Riven-Huang/Photography_Fill_Light/docs/market_report_60w_80w_fill_lights_2026-03-22.md

# 60W-80W 便携型补光灯竞品对比报告

更新日期：2026-03-22

## 1. 报告目的

我写这份报告的目的很明确：如果后续把 `Photography_Fill_Light` 项目继续推进为便携型补光灯，我需要先看清它与市面主流 60W-80W 产品之间的差距，以及更合适的对标对象和价格区间。

## 2. 项目介绍

### 2.1 项目定位

我当前推进的是一个便携型补光灯方向的电子设计项目。项目的核心不是单独完成一块驱动板，而是围绕 `60W-80W` 功率段，逐步形成一套具备继续商品化潜力的补光灯方案。

从现有资料看，这个项目目前还处在样机与控制验证阶段，因此我对它的定义更偏向：

- 便携型补光灯方向的控制原型
- 以电源、恒流和调光为核心的技术样机
- 尚未完成整机工业设计和商品化指标闭环

### 2.2 目标方向

从当前讨论方向看，我把这个项目的目标理解为：

- 面向便携型补光灯赛道
- 功率落在 `60W-80W` 区间
- 强调稳定调光和连续光输出
- 后续需要与神牛、优篮子、智云等便携型产品做正面对比

从市场对比角度出发，我后续更关心的不是“能不能点亮”，而是它最终能否落到下面这些整机属性上：

- 是否足够便携
- 是否具备合适的供电方式
- 是否具备可接受的亮度和噪声表现
- 是否能进入合理价格区间

### 2.3 当前技术路线

结合现有文档和代码，我对本项目当前技术路线的概括是：

- 采用 `Boost + 线性恒流` 的总体架构
- 通过 `ADC + DMA` 进行采样与标定
- 通过 `PI` 控制完成母线调节
- 通过 `EC11` 完成交互与调光输入
- 已经具备软启动、过压保护和基本状态机逻辑

这条路线的特点是控制思路比较清晰，便于先把恒流、调光和动态余量控制做好；但如果继续朝便携型成品推进，后续还必须补齐结构、散热、供电、重量和噪声等整机问题。

### 2.4 当前完成情况

目前已经完成的部分主要包括：

- `ADC + DMA` 采样与标定
- `Boost + 线性恒流` 控制框架
- `PI` 调压、软启动、过压保护、状态机
- `EC11` 调光交互

目前还缺少、且无法直接与市售产品对比的数据主要包括：

- 1m 照度
- 整机重量
- 满功率风扇噪声
- 供电方式与续航能力
- 实际整机效率

基于这些现状，我目前认为本项目已经具备继续做市场对标分析的基础，但还没有进入“整机定型”的阶段。

## 3. 我关注的对比重点

在这类便携型补光灯上，我认为真正决定竞争力的不是单一功率，而是下面几项：

- 重量
- 供电方式
- 1m 照度
- 显指
- 风扇噪声
- 售价

市面主流 60W-80W 便携型产品，通常已经把这些点做到比较完整：

- 重量大致控制在 `250g-700g`
- 普遍支持 `PD`、`NP-F`、手柄电池或外接电池
- 有比较清晰的 1m 照度宣传口径
- 显指通常标到 `CRI 95+`
- 价格大致集中在 `579-1399 元`

而本项目当前最明显的差距是：

- 便携供电方案还没有定型
- 整机重量目标还没有锁定
- 照度、噪声、效率还没有实测数据
- 当前优势主要仍然停留在控制架构层面

## 4. 重点竞品对比

### 4.1 Godox ML60II Bi

`Godox ML60II Bi` 我把它视为便携专业型的基准产品之一。

公开可见参数大致为：

- 功率：`70W`
- 色温：`2800K-6500K`
- 显指：`CRI 96 / TLCI 97`
- 照度：`22500 lux @1m, 5600K, 带标罩`
- 重量：约 `526g`
- 供电：`AC`、`NP-F`、V 口扩展
- 价格：约 `898 元`

和本项目相比，我看到的差异主要是：

- 它已经完成整机形态
- 它的便携供电方案成熟
- 它的亮度口径清晰
- 它的品牌和附件生态完整

如果我后续把本项目定位为便携专业型，我认为至少要在下面几项尽量接近它：

- 重量
- 供电方式
- 1m 照度
- 风扇噪声

淘宝截图预留：

- 这里插入 `Godox ML60II Bi` 商品主图
- 这里插入 `Godox ML60II Bi` 价格页截图
- 这里插入 `Godox ML60II Bi` 参数页截图

### 4.2 Ulanzi EC65

`Ulanzi EC65` 我把它看成轻量化和平价便携路线的代表产品。

公开可见参数大致为：

- 功率：`65W`
- 色温：`2500K-6500K`
- 显指：`CRI 95+`
- 重量：约 `250g`
- 供电：`PD`、`DC`、部分套餐带电池
- 价格：`579 元` 起

这款产品最强的地方不是绝对亮度，而是：

- 够轻
- 够便宜
- 便携感强

和本项目相比，它给我的提醒是：

- 如果我把价格目标压到 `599-699 元` 区间，就会直接面对这种低价轻量型产品
- 如果本项目在重量和供电上没有优势，仅靠控制架构本身并不足以形成竞争力

淘宝截图预留：

- 这里插入 `Ulanzi EC65` 商品主图
- 这里插入 `Ulanzi EC65` 套餐价格截图
- 这里插入 `Ulanzi EC65` 参数页截图

### 4.3 ZHIYUN MOLUS X60

`ZHIYUN MOLUS X60` 在我看来代表的是极致小体积便携路线。

公开可见参数大致为：

- 功率：`60W`
- 色温：`2700K-6500K`
- 显指：主流公开口径为 `CRI 95+ / TLCI 97+`
- 供电：`PD`、手柄电池、适配器扩展
- 价格：促销时约 `709 元`

这款产品的核心卖点不是单纯参数，而是：

- 小体积
- 适合外拍
- 整机看起来就是便携创作工具

和本项目相比，我更关注的不是光学参数差异，而是产品完成度差异：

- 本项目当前仍然偏控制原型
- `MOLUS X60` 已经是成熟的便携产品逻辑

淘宝截图预留：

- 这里插入 `ZHIYUN MOLUS X60` 商品主图
- 这里插入 `ZHIYUN MOLUS X60` 价格页截图
- 这里插入 `ZHIYUN MOLUS X60` 供电或尺寸截图

### 4.4 SmallRig RC 60B

`SmallRig RC 60B` 我把它归类为便携型里更强调整机完整度的一类产品。

公开可见参数大致为：

- 功率：`63W`
- 色温：`2700K-6500K`
- 显指：`CRI 97 / TLCI 98 / SSI 89`
- 照度：`11200-13000 lux @1m, 带反光罩`
- 电池：内置约 `49Wh`
- 重量：约 `650g`
- 价格：约 `1369 元`

这类产品的竞争逻辑不是低价，而是：

- 整机完成度高
- 电池方案完整
- 规格表达更完整

和本项目相比，它说明了一件事：如果我未来希望把本项目推向中高端便携型，就不能只把灯头做出来，还需要同时把下面几项补齐：

- 续航
- 便携供电
- 整机做工
- 用户体验

淘宝截图预留：

- 这里插入 `SmallRig RC 60B` 商品主图
- 这里插入 `SmallRig RC 60B` 电池或续航截图
- 这里插入 `SmallRig RC 60B` 价格页截图

### 4.5 amaran COB 60x S

`amaran COB 60x S` 我把它看成 60W 档位里偏专业、偏完整规格的强势竞品。

公开可见参数大致为：

- 输出功率：`65W`
- 最大功耗：`78W`
- 色温：`2700K-6500K`
- 显指：`CRI 96+ / TLCI 97+ / SSI(T) 90+ / SSI(D56) 87+`
- 照度：`33300 lux @1m, 带反光罩`
- 供电：`AC`、双 `NP-F`、电池扩展
- 重量：约 `695g`
- 价格：约 `1094 元`

这款产品对我的参考价值主要在于：

- 如果我不把最低价作为主要竞争点
- 而是更重视“更专业、更稳定、更完整”

那么 `amaran COB 60x S` 会比单纯观察低价产品更有参考意义。

淘宝截图预留：

- 这里插入 `amaran COB 60x S` 商品主图
- 这里插入 `amaran COB 60x S` 参数页截图
- 这里插入 `amaran COB 60x S` 价格页截图

## 5. 我的直接结论

如果只看便携型路线，我当前更倾向于把本项目目标先收敛到下面这个范围：

- 功率：`60W-70W`
- 色温：`双色温`
- 供电：优先支持 `PD 100W`
- 重量：尽量进入 `700g` 以内
- 售价：优先落在 `599-899 元`

从竞品情况看，我当前对标优先级的判断是：

第一优先级：

- `Godox ML60II Bi`
- `Ulanzi EC65`

第二优先级：

- `ZHIYUN MOLUS X60`

第三优先级：

- `amaran COB 60x S`
- `SmallRig RC 60B`

我这样排序的原因也很直接：

- `ML60II Bi` 是便携专业型的主流基准
- `EC65` 是低价轻量路线的直接压力
- `X60` 代表小体积便携设计方向
- `amaran` 和 `SmallRig` 更适合做高位规格参考

## 6. BOM 成本测算预留

### 6.1 核心电子 BOM

| 模块 | 器件/规格 | 型号/方案 | 单价(元) | 数量  | 小计(元) | 备注  |
| --- | --- | --- | ----- | --- | ----- | --- |
| 主控 | MCU | STM32F030F4P6TR  | | 1 | | |
| Boost 驱动 | 半桥驱动 | MP1907 | | 1 | | |
| 运放 | 恒流控制运放 | TLV2372 | | 1 | | |
| 主功率 MOS  | Boost 功率管 | | | 2 | | |
| 线性 MOS | 恒流调整管 | IXTH30N50L2 | | 1 | | |
| 电感 | 主电感 | 33uH | | 1 | | |
| 采样电阻 | 恒流采样 | 0.1 ohm | | 1 | | |
| 降压电源 | 电源级 | MP4420 / MP20051 | | 3 | | |
| 编码器 | 人机交互 | EC11 | | 1 | | |
| 风扇驱动 | 低边 MOS | AO3400A | | 1 | | |
| COB 光源 | LED 模组 | | | 1 | | |
| 其他被动件 | 电阻/电容/二极管/连接器 | | | 1批  | | |

### 6.2 结构与散热 BOM

| 模块 | 器件/规格 | 型号/方案 | 单价(元) | 数量  | 小计(元) | 备注  |
| ----- | --- | ----- | ----- | --- | ----- | --- |
| 散热器 | 铝型材/压铸件  | | | 1 | | |
| 风扇 | 散热风扇 | | | 1 | | |
| 外壳 | 上下盖/边框 | | | 1套  | | |
| 支架/手柄 | 结构附件 | | | 1 | | |
| 导热材料  | 导热垫/导热硅脂 | | | 1批  | | |
| 紧固件 | 螺丝/铜柱/垫片 | | | 1批  | | |

### 6.3 供电、包装与附件 BOM

| 模块 | 器件/规格 | 型号/方案 | 单价(元) | 数量  | 小计(元) | 备注  |
| --- | --- | ----- | ----- | --- | ----- | --- |
| 适配器 | AC-DC 电源 | | | 1 | | |
| PD 供电板 | 若采用 PD 方案 | | | 1 | | |
| 电池方案 | 若采用电池包/手柄电池 | | | 1 | | |
| 反光罩 | 标配附件 | | | 1 | | |
| 线材 | 电源线/转接线 | | | 1批  | | |
| 包装盒 | 彩盒/内衬 | | | 1 | | |
| 说明书 | 文档印刷 | | | 1 | | |

### 6.4 成本汇总

| 项目 | 金额(元) | 备注  |
| --- | ----- | --- |
| 核心电子 BOM 小计 | | |
| 结构与散热 BOM 小计 | | |
| 供电、包装与附件 BOM 小计 | | |
| 加工与试产损耗 | | |
| 预计整机物料成本 | | |
| 目标出厂价 | | |
| 目标零售价 | | |

## 7. 参考来源

- 项目文档与代码：
  - `docs/CURRENT_OPERATION_MANUAL.md`
  - `docs/DYNAMIC_HEADROOM_STRATEGY.md`
  - `program/app/program.c`
  - `program/app/state_machine.c`
- 竞品公开资料：
  - Godox ML60II Bi 中国首发信息：<https://news.zol.com.cn/877/8779347.html>
  - Godox ML60II Bi 渠道规格页：<https://jonocraztech.cyberbiz.co/products/godox_ml60ii_bi>
  - Ulanzi EC65 首发报道：<https://www.ithome.com/0/836/183.htm>
  - Ulanzi EC65 官方页：<https://www.ulanzieg.com/products/ulanzi-ec65-65w-portable-bi-color-led-video-light>
  - ZHIYUN MOLUS X60 官方商城：<https://store.zhiyun-tech.com/products/molus-x60>
  - SmallRig RC 60B 官方页：<https://www.smallrig.com/RC-60B-COB-LED-Video-Light.html>
  - SmallRig RC 60B 零售页：<https://www.walmart.com/ip/5205392629>
  - amaran COB 60x S 官方页：<https://amarancreators.com/products/amaran-cob-60x-s>
