Riven-Huang/Photography_Fill_Light/docs/images/架构图.png

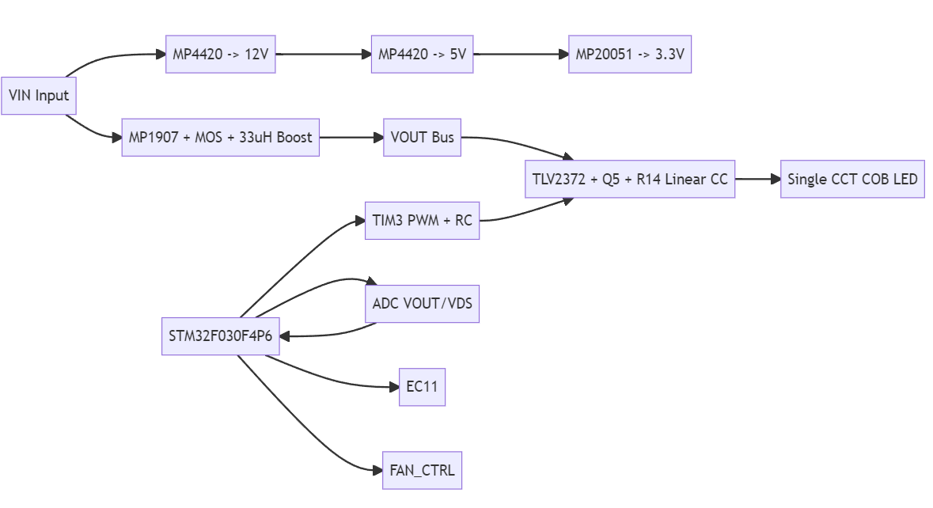
docs/images/架构图.png
