Riven-Huang/Photography_Fill_Light/circurit/SCH_Schematic1_2026-03-04.pdf

STM32F030F4P6TR | POWER | Auxiliary POWER

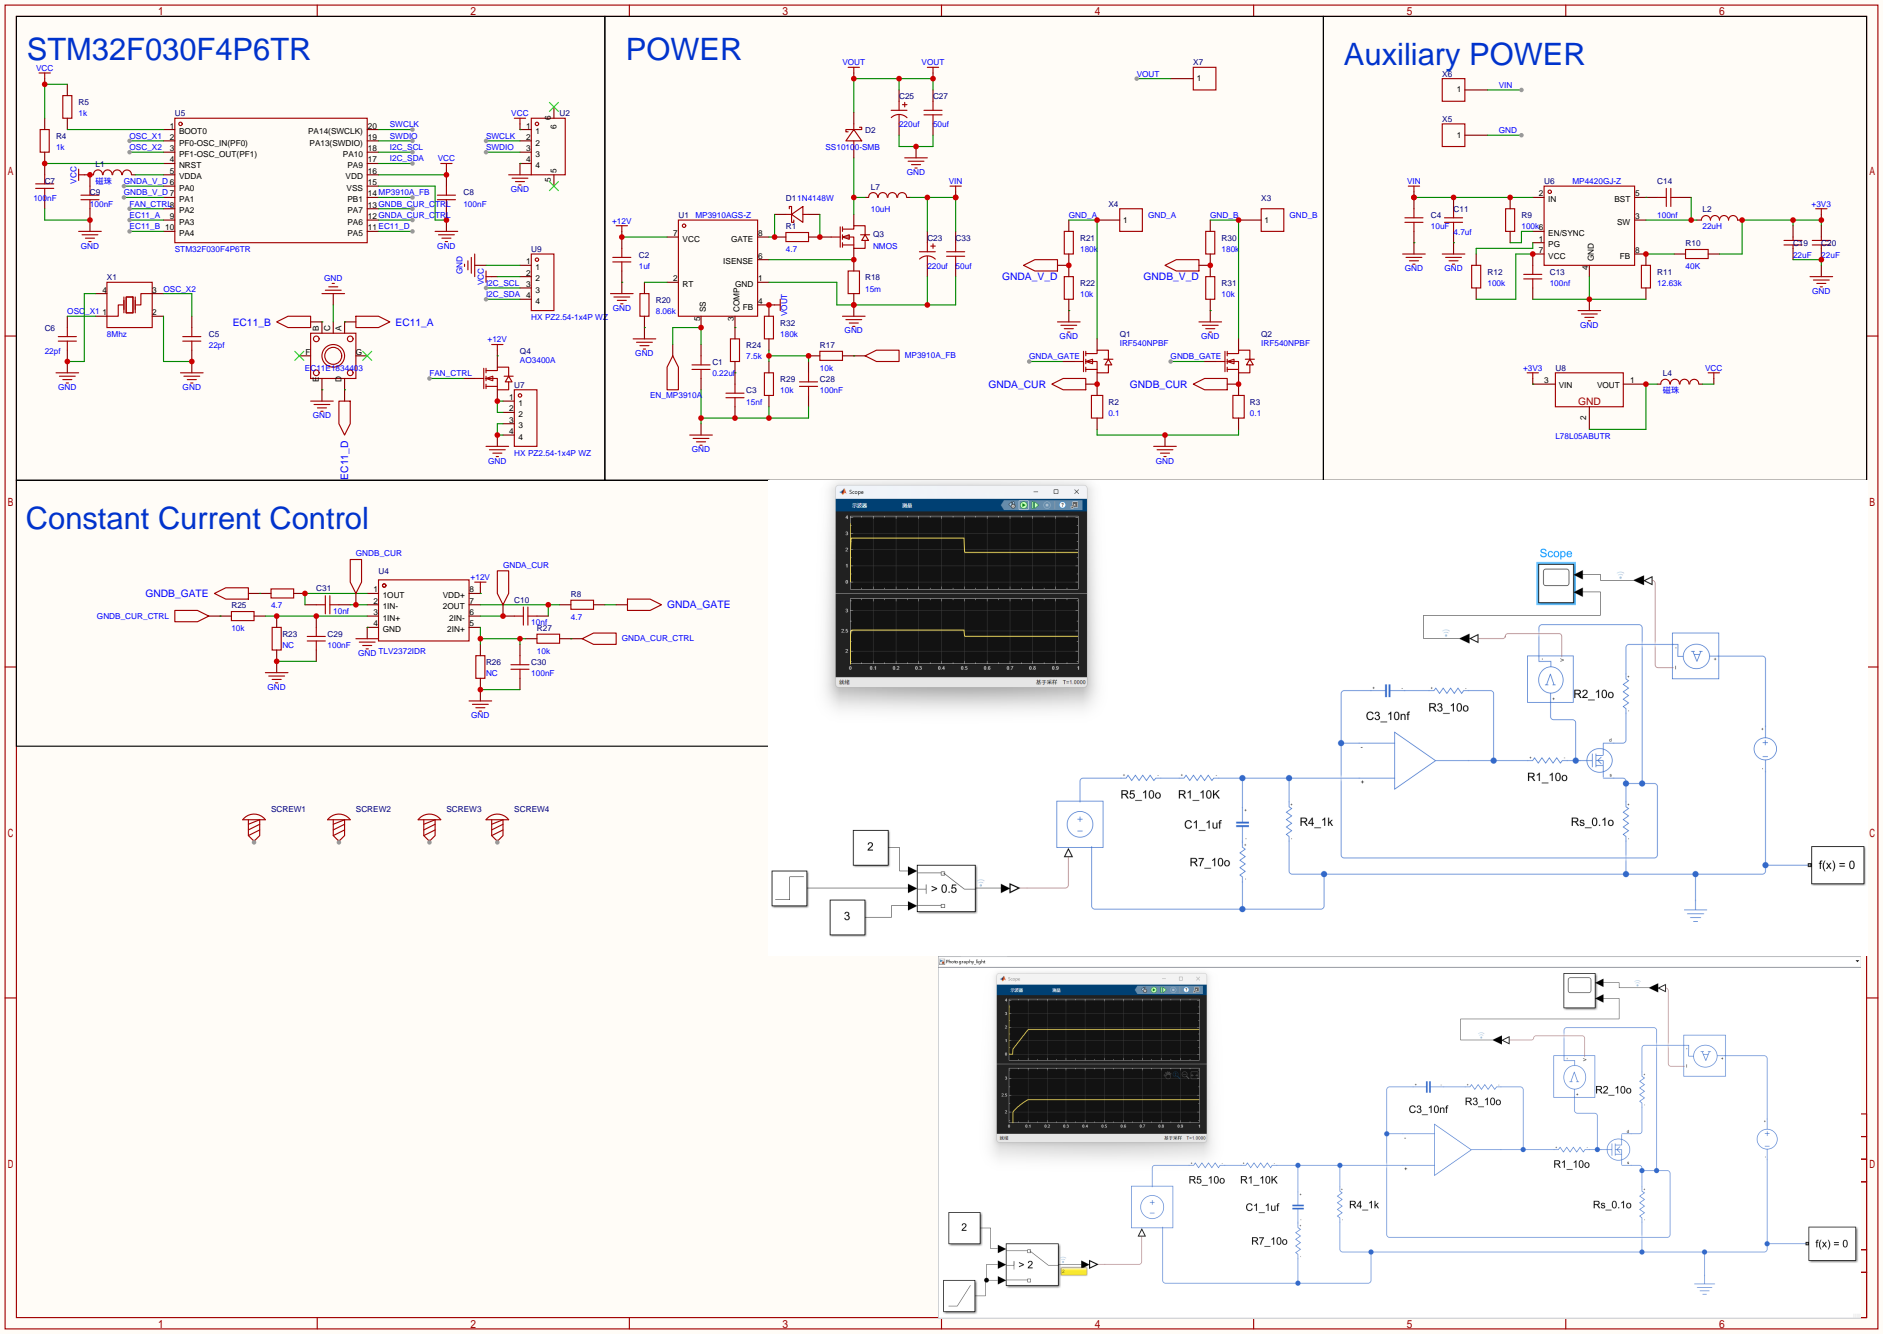
[picture p19: page 1]

原理图 | Schematic1 | 创建日期 | 2026-01-12

更新日期 | 2026-03-04

板子 | Board1 | 图页 | P1
绘制 | | 补光灯
审阅

V1.0 | A3 | 嘉立创EDA
