Riven-Huang/Photography_Fill_Light/circurit/SCH_单色温_2026-03-20.pdf

# STM32F030F4P6TR

# 辅助电源

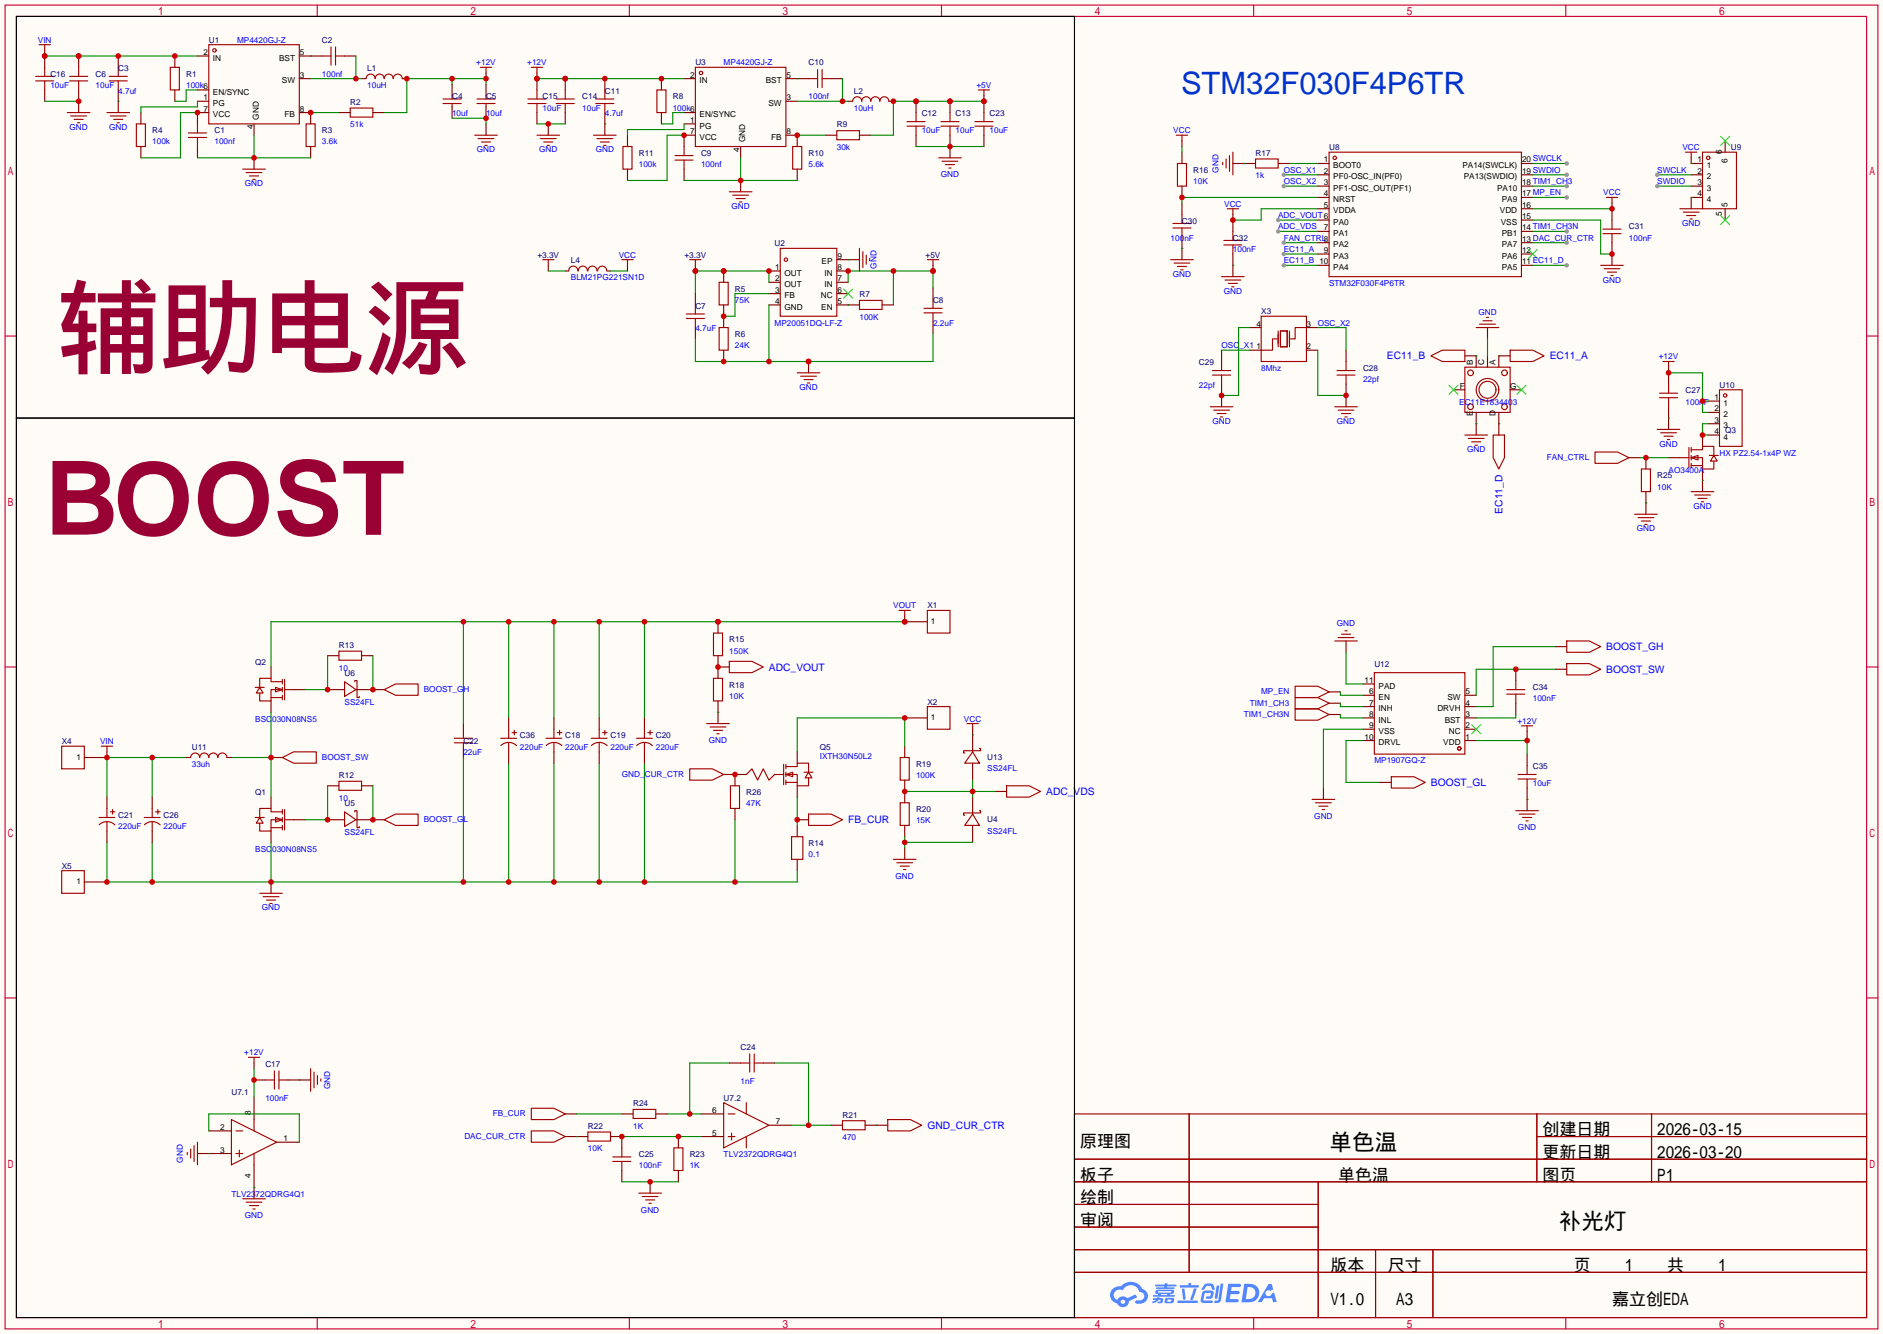
[picture p20: page 1]

原理图 | 单色温 | 创建日期 | 2026-03-15

更新日期 | 2026-03-20

板子 | 单色温 | 图页 | P1
绘制 | | 补光灯
审阅

V1.0 | A3 | 嘉立创EDA
