Riven-Huang/Photography_Fill_Light/(commit log)

2026-03-21 Upload current Photography_Fill_Light project
    [TLV2372.DSN, TLV2372.OLB, TLV2372.opj]
2026-03-30 Update README with design highlights, add thermal design docs and MPS QR code
    [thermal_budget.csv]
2026-03-31 Add manufacture files
    [Drill_PTH_Through.DRL, Drill_PTH_Through_Via.DRL, Gerber_BoardOutlineLayer.GKO, Gerber_BottomLayer.GBL, Gerber_BottomPasteMaskLayer.GBP, Gerber_BottomSilkscreenLayer.GBO, Gerber_BottomSolderMaskLayer.GBS, Gerber_TopLayer.GTL]
