Riven-Huang/Photography_Fill_Light/(notices)

Notices in the files:
program/Core/Inc/main.h:
Copyright (c) 2026 STMicroelectronics.
All rights reserved.
This software is licensed under terms that can be found in the LICENSE file
